wt-umi/WTUMI-Hardware/assets/hand_3.png

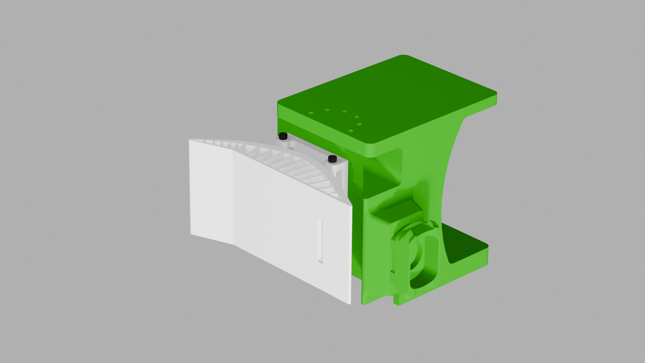
assets/hand_3.png
