wt-umi/WTUMI-Hardware/assets/w3.png

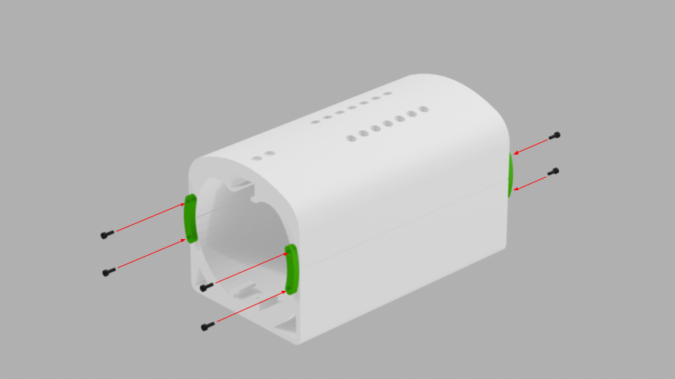
assets/w3.png
