wt-umi/WTUMI-Hardware/assets/w10b.jpg

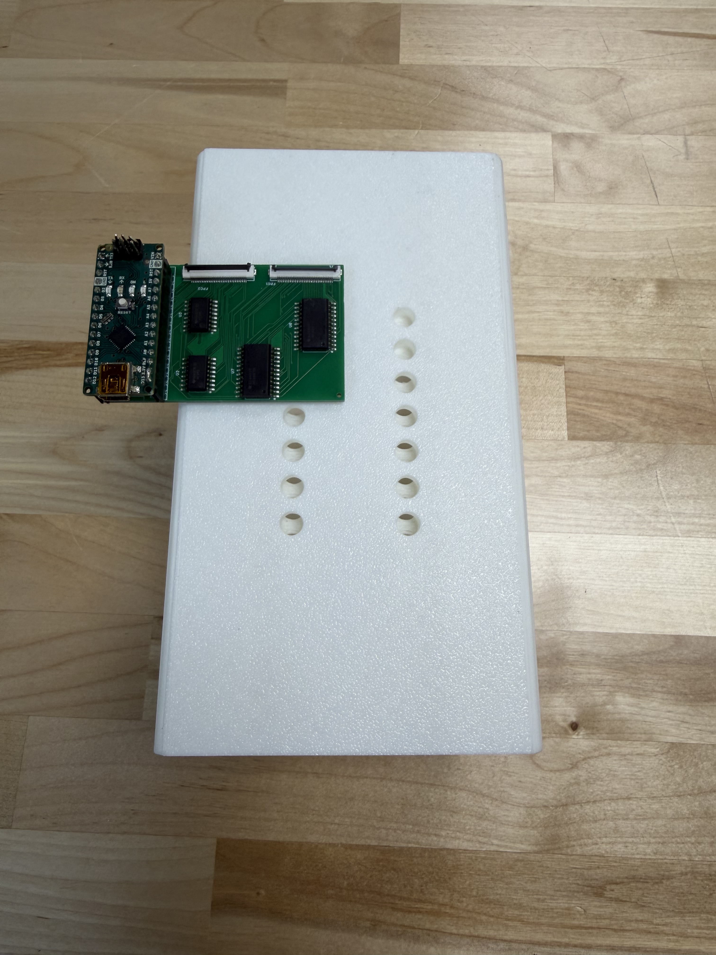
assets/w10b.jpg
