wt-umi/WTUMI-Hardware/Chest Plate/chestPlate_mainPlate.step

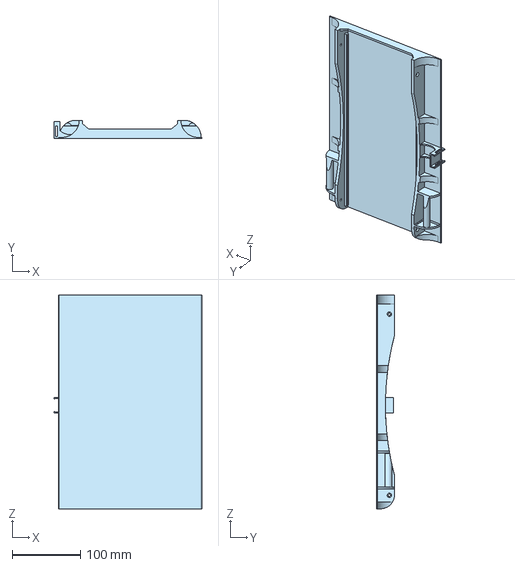
[picture p31: CAD file, 2026-06-17]
Chest Plate/chestPlate_mainPlate.step
216.0 x 27.0 x 313.0 mm
