wt-umi/WTUMI-Hardware/GripTac/griptac_main_L.step

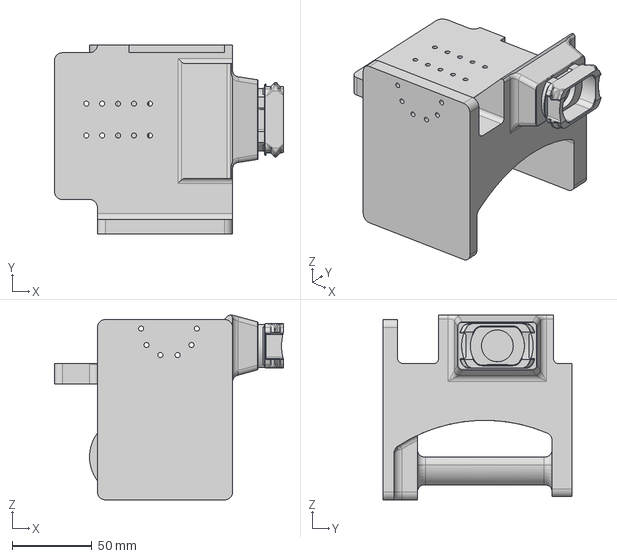
[picture p32: CAD file, 2026-06-17]
GripTac/griptac_main_L.step
144.0 x 119.1 x 116.2 mm
