wt-umi/WTUMI-Hardware/Forearm Cover/forearmCover_wrist-adaper.step

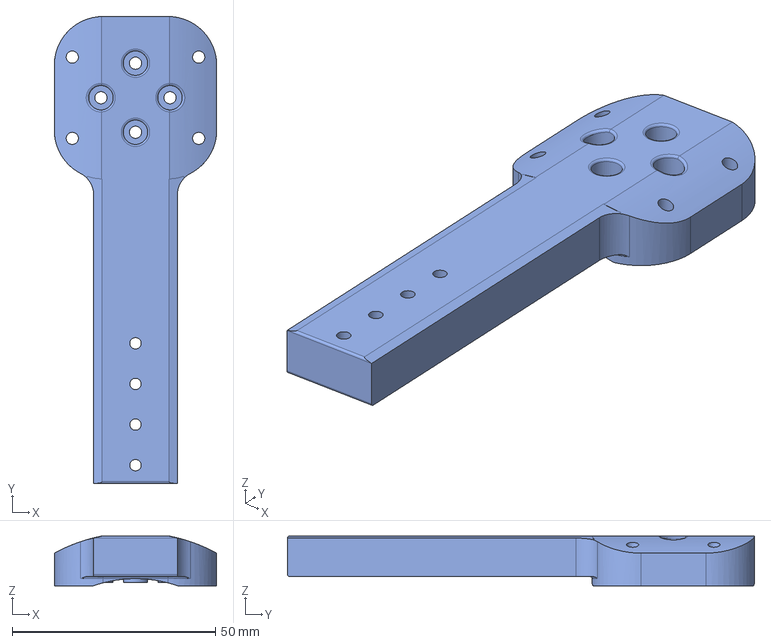
[picture p33: CAD file, 2026-06-17]
Forearm Cover/forearmCover_wrist-adaper.step
40.0 x 115.0 x 12.3 mm
