wt-umi/WTUMI-Hardware/Chest Plate/chestPlate_chestAdapter.step

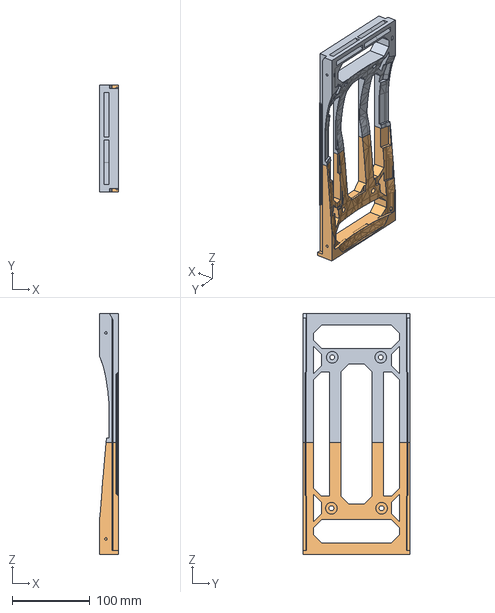
[picture p34: CAD file, 2026-06-17]
Chest Plate/chestPlate_chestAdapter.step
24.0 x 138.0 x 310.0 mm
(Unsaved) x 2
