wt-umi/WTUMI-Hardware/Forearm Cover/forearmCover_connector.step

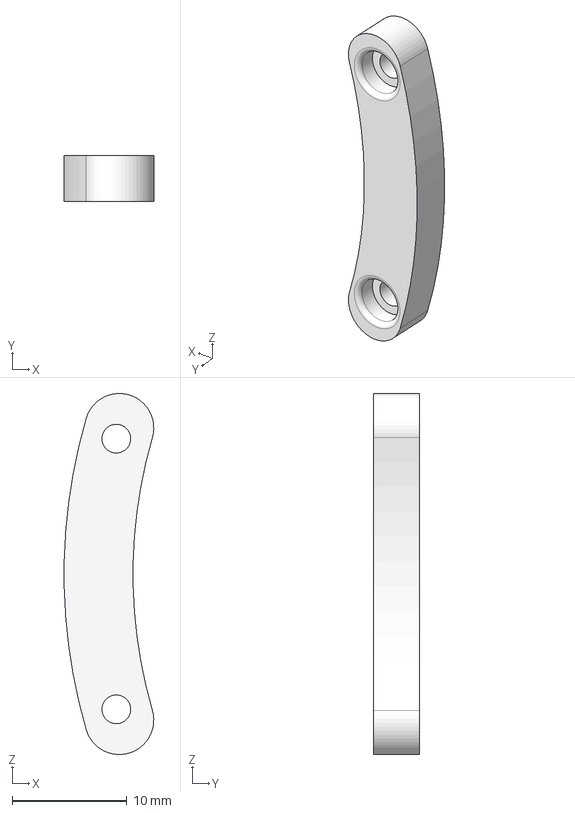
[picture p35: CAD file, 2026-06-17]
Forearm Cover/forearmCover_connector.step
7.79 x 4.00 x 31.4 mm
