wt-umi/WTUMI-Hardware/Forearm Cover/forearmCover_top.step

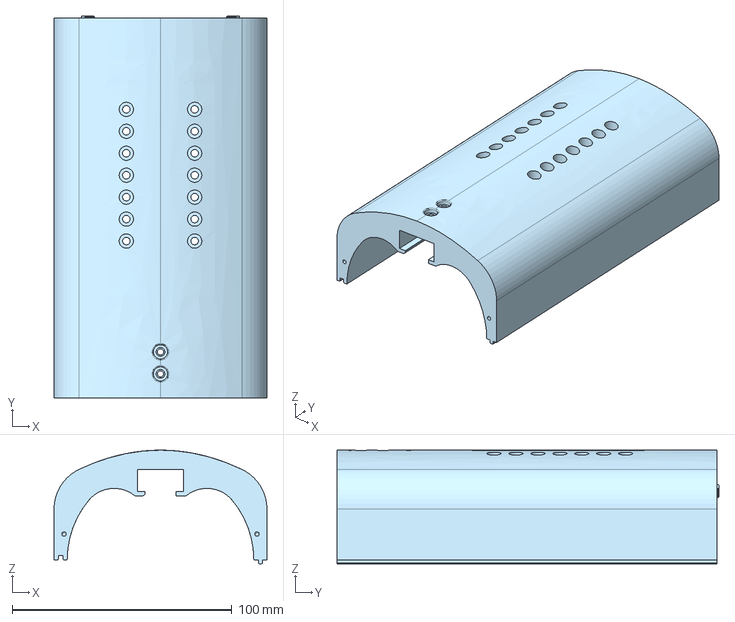
[picture p36: CAD file, 2026-06-17]
Forearm Cover/forearmCover_top.step
97.0 x 174.0 x 51.8 mm
