wt-umi/WTUMI-Hardware/GripTac/griptac_calibrationPiece.step

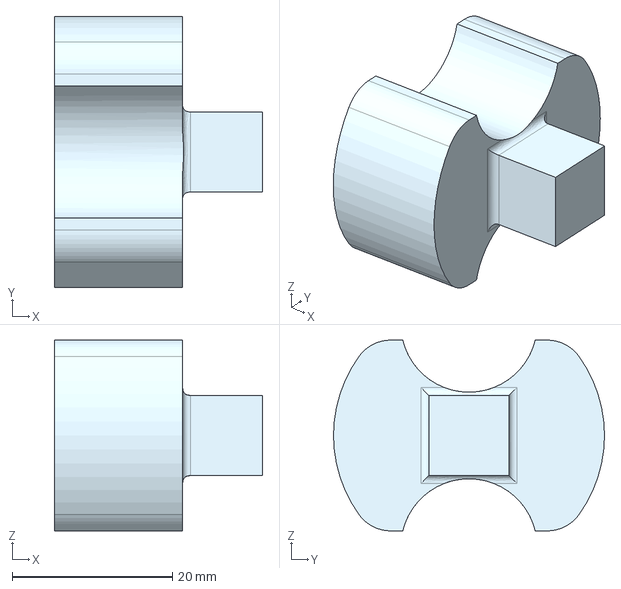
[picture p37: CAD file, 2026-06-17]
GripTac/griptac_calibrationPiece.step
26.0 x 33.8 x 23.8 mm
