wt-umi/WTUMI-Hardware/GripTac/griptac_picoMount_R.step

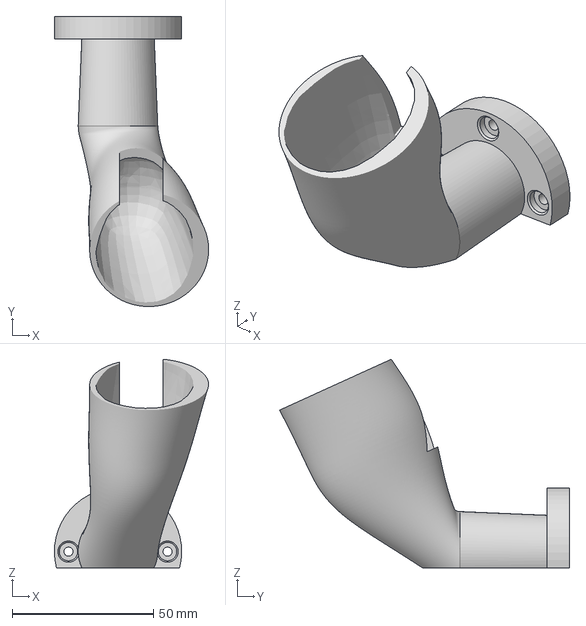
[picture p39: CAD file, 2026-06-17]
GripTac/griptac_picoMount_R.step
54.5 x 102.5 x 73.7 mm
