wt-umi/WTUMI-Hardware/GripTac/griptac_fingerAdapter.step

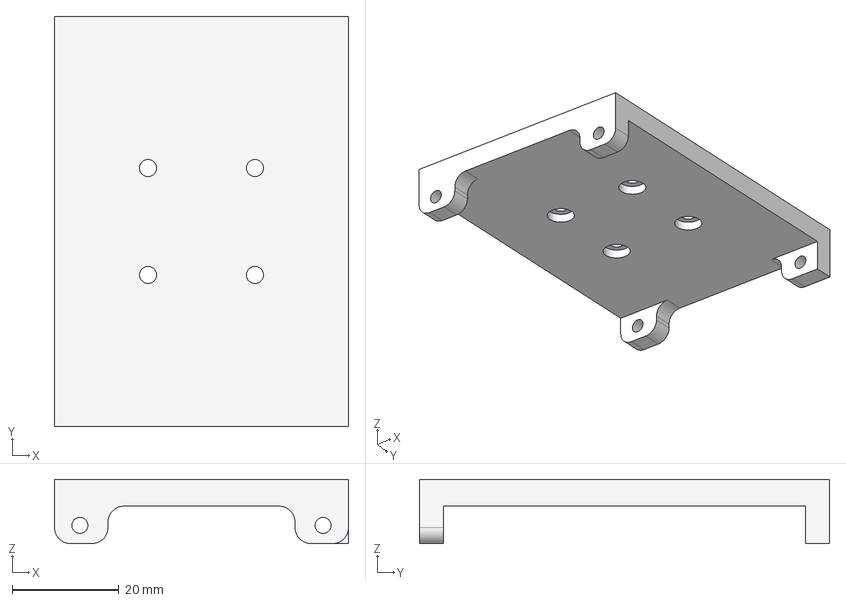
[picture p40: CAD file, 2026-06-17]
GripTac/griptac_fingerAdapter.step
55.0 x 76.7 x 12.0 mm
