wt-umi/WTUMI-Hardware/GripTac/griptac_TPUfinger.step

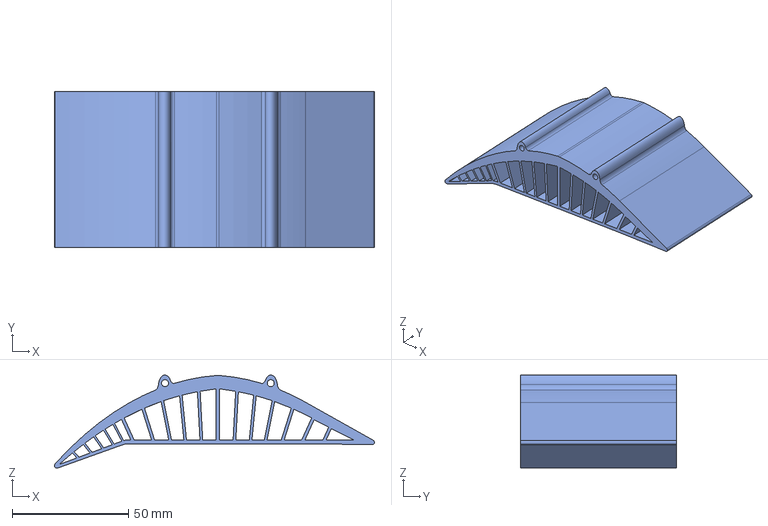
[picture p41: CAD file, 2026-06-17]
GripTac/griptac_TPUfinger.step
137.7 x 67.0 x 40.0 mm
