wt-umi/WTUMI-Hardware/(list of files, cad)

Other CAD files:
GripTac/griptac_main_R.step
GripTac/griptac_picoMount_L.step
