wt-umi/WTUMI-Hardware/assets/c7.jpg

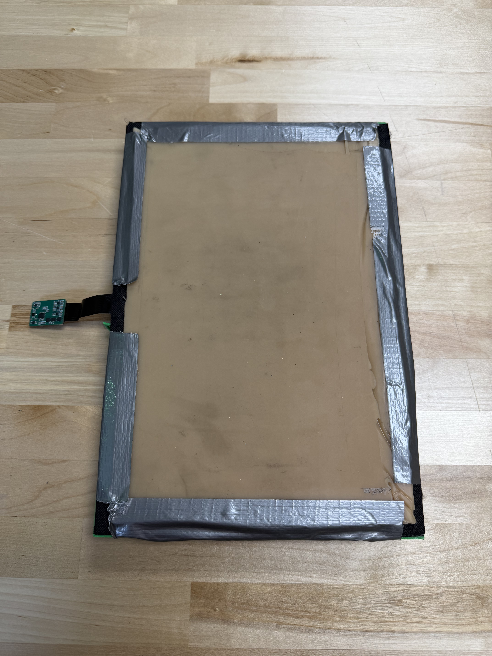
[picture p1: assets/c7.jpg]
assets/c7.jpg
