wt-umi/WTUMI-Hardware/assets/w5.jpg

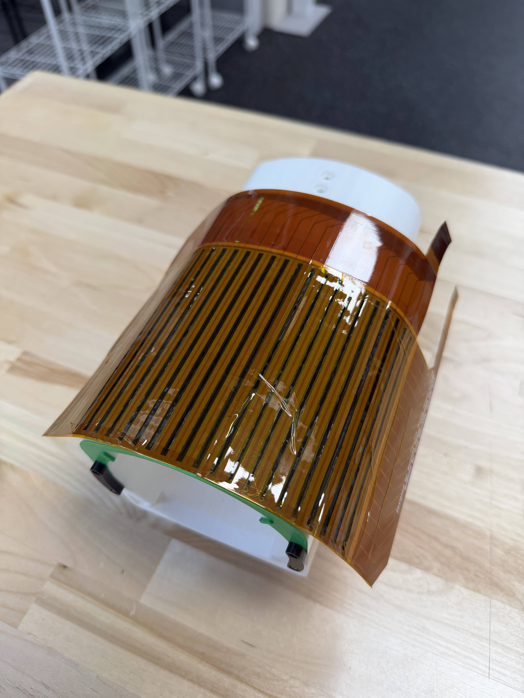
[picture p8: assets/w5.jpg]
assets/w5.jpg
