wt-umi/WTUMI-Hardware/assets/w6.jpg

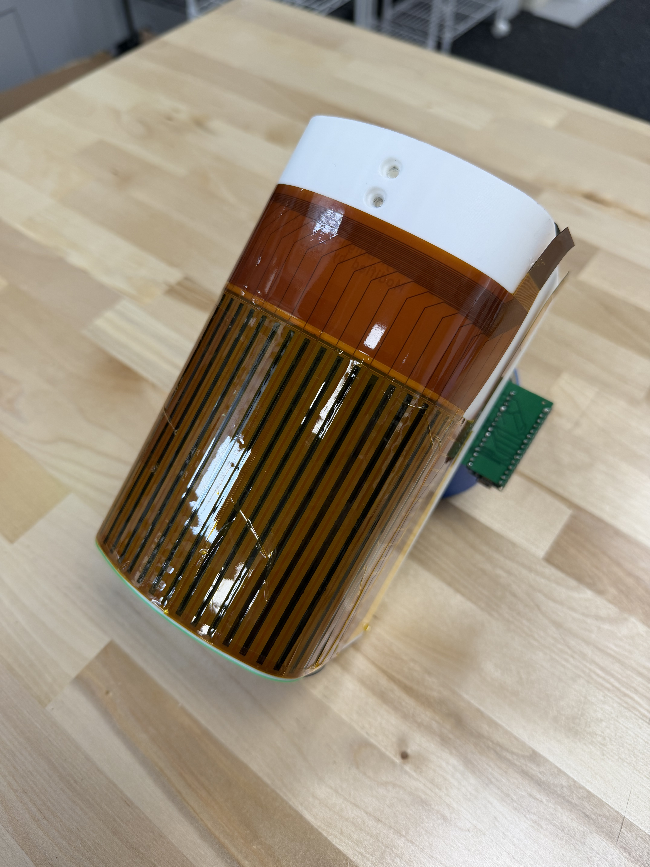
[picture p9: assets/w6.jpg]
assets/w6.jpg
