wt-umi/WTUMI-Hardware/assets/w7.jpg

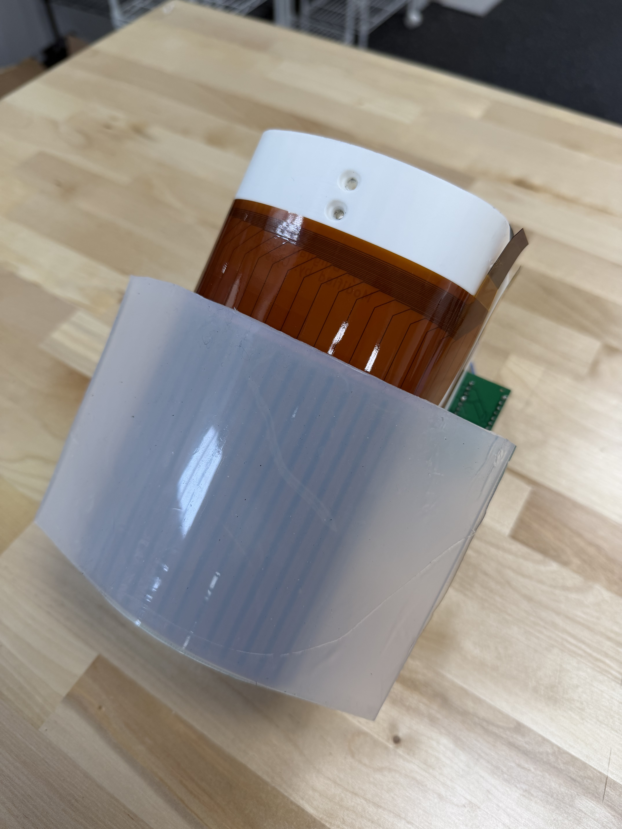
[picture p10: assets/w7.jpg]
assets/w7.jpg
