wt-umi/WTUMI-Hardware/assets/w8.jpg

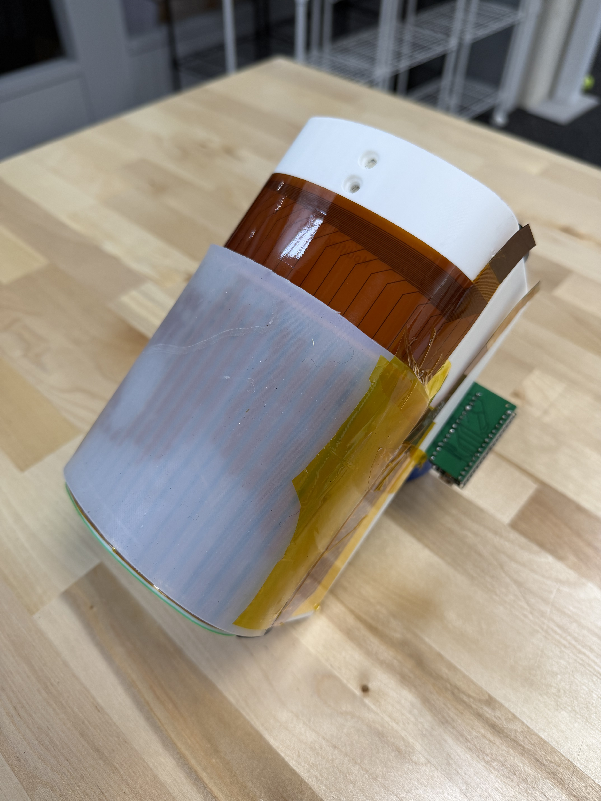
[picture p11: assets/w8.jpg]
assets/w8.jpg
