wt-umi/WTUMI-Hardware/assets/w9.jpg

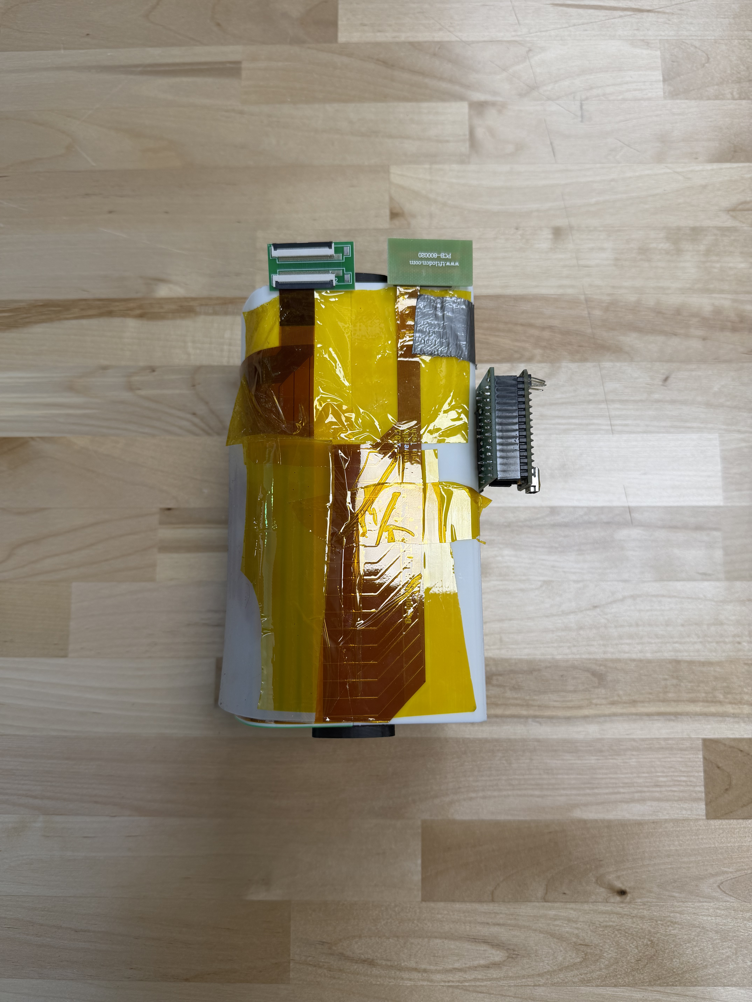
[picture p12: assets/w9.jpg]
assets/w9.jpg
