wt-umi/WTUMI-Hardware/assets/g11.jpg

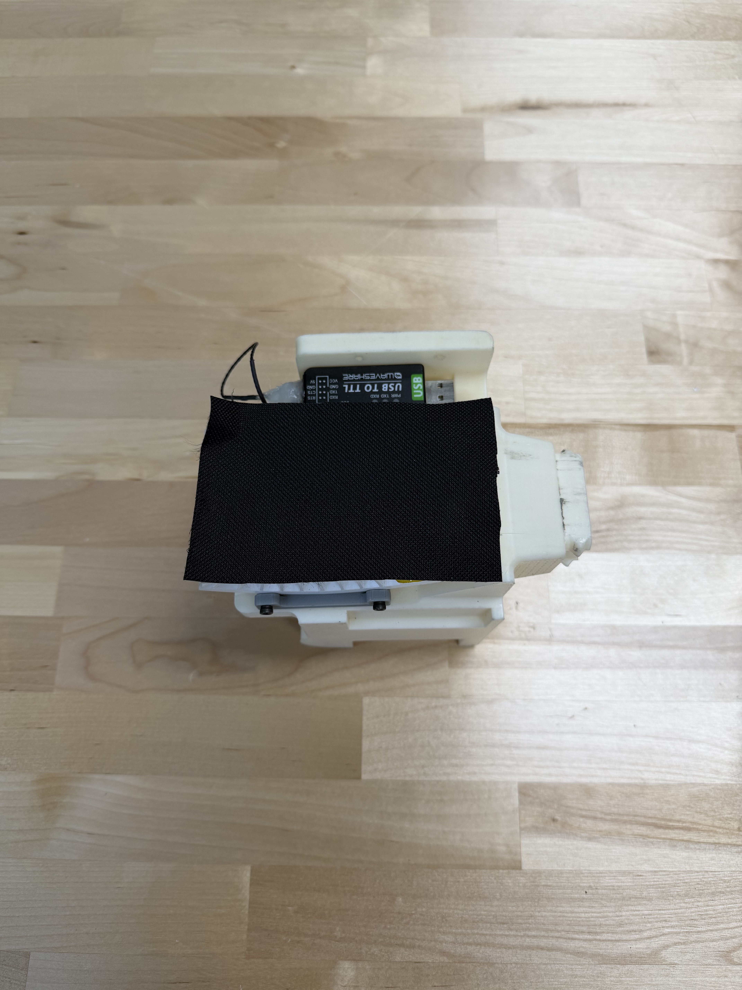
[picture p24: assets/g11.jpg]
assets/g11.jpg
